dragonundertheworld/module-robot/img/final_robot.jpg

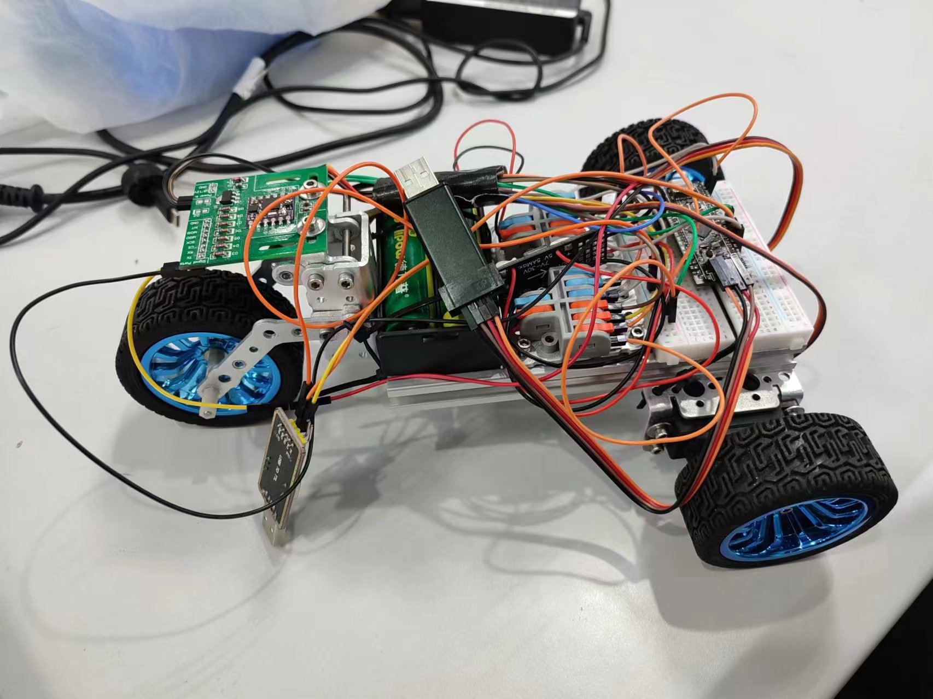
img/final_robot.jpg
