dragonundertheworld/module-robot/img/code_of_yaw_calibration.png

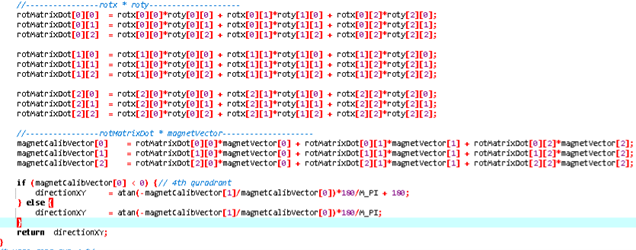
img/code_of_yaw_calibration.png
