dragonundertheworld/module-robot/img/test_and_record.jpg

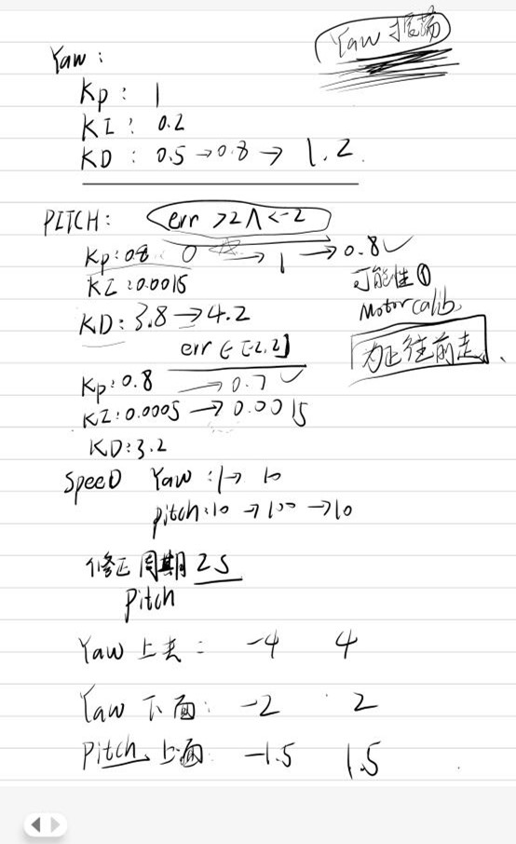
img/test_and_record.jpg
