dragonundertheworld/module-robot/Core/Src/main.c

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
/* Includes ------------------------------------------------------------------*/
#include "main.h"
#include "cmsis_os.h"

/* USER CODE BEGIN Includes */
#include "stdio.h"
#include "stdlib.h"
#include "string.h"
/* USER CODE END Includes */

/* USER CODE BEGIN PTD */
int SPEED;//要达到的速度
float PitchTemp = 0;
float YawTemp = 0;
float YawAngleCalibration = -42;
float PitchAngleCalibration = 3 ;
float PitchAverage = 0;
float YawAverage = 0;
int YawCorrectionSpeed = 0;
float PitchError = 0;
float SUM = 0;
int	flag=0;
typedef union {
    uint16_t   U16Data;
    int16_t    I16Data;
    int16_t    T16Data;
    uint8_t    C8Data[2];
}DataJointUnion;
typedef union {
    int16_t	   P16Data;
    uint8_t    P8Data[2];
}DataPitchUnion;

typedef union {
    int16_t	   Y16Data;
    uint8_t    Y8Data[2];
}DataYawUnion;

/* USER CODE END PTD */

/* USER CODE BEGIN PD */
#define	UART2_RECV_BUFF_LEN			11
#define UART1_RECV_BUFF_LEN         11
#define UART1_TRANS_BUFF_LEN        64
#define UART2_SEND_BUFF_LEN         64
#define	Pitch_Buff_LEN				64
#define	Yaw_Buff_LEN				64

/* USER CODE END PD */

TIM_HandleTypeDef htim2;

UART_HandleTypeDef huart1;
UART_HandleTypeDef huart2;

osThreadId defaultTaskHandle;
osThreadId myTask02Handle;
osThreadId myTask03Handle;
osThreadId myTask04Handle;
osThreadId myTask05Handle;
osThreadId myTask06Handle;
osSemaphoreId myBinarySem_UART1GY953RecvHandle;
osSemaphoreId myBinarySem_UART2SendHandle;
osSemaphoreId myBinarySem_UART1ToUART2TransReadyHandle;
osSemaphoreId myBinarySem_UART2RecvHandle;
osSemaphoreId myBinarySem_MotorSpdChangeHandle;
osSemaphoreId myBinarySem_YawCorrectionHandle;
osSemaphoreId myBinarySem_PitchCorrectionHandle;
osSemaphoreId myBinarySem_YawCorrectHandle;
/* USER CODE BEGIN PV */
uint8_t     UART1RecvBuff[UART1_RECV_BUFF_LEN];
uint8_t     UART1TransToUART2Buff[UART1_TRANS_BUFF_LEN];
int16_t     PitchBuff[Pitch_Buff_LEN];
int16_t     YawBuff[Pitch_Buff_LEN];
uint16_t    UART1TransToUART2Size=0;
uint16_t    PitchSize=0;
uint16_t    YawSize=0;
uint16_t    UART2SendSize=0;
uint8_t     UART2SendBuff[UART2_SEND_BUFF_LEN];
uint8_t 	UART2RecvBuff[UART2_RECV_BUFF_LEN];
/* USER CODE END PV */

void SystemClock_Config(void);
static void MX_GPIO_Init(void);
static void MX_TIM2_Init(void);
static void MX_USART1_UART_Init(void);
static void MX_USART2_UART_Init(void);
void StartDefaultTask(void const * argument);
void StartTaskUART1GY953(void const * argument);
void StartTaskUART2(void const * argument);
void StartTaskMotorCtrl(void const * argument);
void StartTaskPID(void const * argument);
void StartTaskYawCorrect(void const * argument);

/**
  * @brief  The application entry point.
  * @retval int
  */
int main(void)
{
  /* MCU Configuration--------------------------------------------------------*/

  /* Reset of all peripherals, Initializes the Flash interface and the Systick. */
  HAL_Init();

  /* Configure the system clock */
  SystemClock_Config();

  /* Initialize all configured peripherals */
  MX_GPIO_Init();
  MX_TIM2_Init();
  MX_USART1_UART_Init();
  MX_USART2_UART_Init();
  /* Create the semaphores(s) */
  /* definition and creation of myBinarySem_UART1GY953Recv */
  osSemaphoreDef(myBinarySem_UART1GY953Recv);
  myBinarySem_UART1GY953RecvHandle = osSemaphoreCreate(osSemaphore(myBinarySem_UART1GY953Recv), 1);

  /* definition and creation of myBinarySem_UART2Send */
  osSemaphoreDef(myBinarySem_UART2Send);
  myBinarySem_UART2SendHandle = osSemaphoreCreate(osSemaphore(myBinarySem_UART2Send), 1);

  /* definition and creation of myBinarySem_UART1ToUART2TransReady */
  osSemaphoreDef(myBinarySem_UART1ToUART2TransReady);
  myBinarySem_UART1ToUART2TransReadyHandle = osSemaphoreCreate(osSemaphore(myBinarySem_UART1ToUART2TransReady), 1);

  /* definition and creation of myBinarySem_UART2Recv */
  osSemaphoreDef(myBinarySem_UART2Recv);
  myBinarySem_UART2RecvHandle = osSemaphoreCreate(osSemaphore(myBinarySem_UART2Recv), 1);

  /* definition and creation of myBinarySem_MotorSpdChange */
  osSemaphoreDef(myBinarySem_MotorSpdChange);
  myBinarySem_MotorSpdChangeHandle = osSemaphoreCreate(osSemaphore(myBinarySem_MotorSpdChange), 1);

  /* definition and creation of myBinarySem_YawCorrection */
  osSemaphoreDef(myBinarySem_YawCorrection);
  myBinarySem_YawCorrectionHandle = osSemaphoreCreate(osSemaphore(myBinarySem_YawCorrection), 1);

  /* definition and creation of myBinarySem_PitchCorrection */
  osSemaphoreDef(myBinarySem_PitchCorrection);
  myBinarySem_PitchCorrectionHandle = osSemaphoreCreate(osSemaphore(myBinarySem_PitchCorrection), 1);

  /* definition and creation of myBinarySem_YawCorrect */
  osSemaphoreDef(myBinarySem_YawCorrect);
  myBinarySem_YawCorrectHandle = osSemaphoreCreate(osSemaphore(myBinarySem_YawCorrect), 1);

  /* Create the thread(s) */
  /* definition and creation of defaultTask */
  osThreadDef(defaultTask, StartDefaultTask, osPriorityNormal, 0, 128);
  defaultTaskHandle = osThreadCreate(osThread(defaultTask), NULL);

  /* definition and creation of myTask02 */
  osThreadDef(myTask02, StartTaskUART1GY953, osPriorityIdle, 0, 128);
  myTask02Handle = osThreadCreate(osThread(myTask02), NULL);

  /* definition and creation of myTask03 */
  osThreadDef(myTask03, StartTaskUART2, osPriorityIdle, 0, 128);
  myTask03Handle = osThreadCreate(osThread(myTask03), NULL);

  /* definition and creation of myTask04 */
  osThreadDef(myTask04, StartTaskMotorCtrl, osPriorityIdle, 0, 128);
  myTask04Handle = osThreadCreate(osThread(myTask04), NULL);

  /* definition and creation of myTask05 */
  osThreadDef(myTask05, StartTaskPID, osPriorityIdle, 0, 128);
  myTask05Handle = osThreadCreate(osThread(myTask05), NULL);

  /* definition and creation of myTask06 */
  osThreadDef(myTask06, StartTaskYawCorrect, osPriorityIdle, 0, 128);
  myTask06Handle = osThreadCreate(osThread(myTask06), NULL);

  /* Start scheduler */
  osKernelStart();

  /* We should never get here as control is now taken by the scheduler */
  /* Infinite loop */
}

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
/* USER CODE BEGIN 4 */
//下面这两个中断是起始
void HAL_UART_RxCpltCallback(UART_HandleTypeDef *huart)
{
    if(huart == &huart1)
    {
        osSemaphoreRelease(myBinarySem_UART1GY953RecvHandle);
        HAL_UART_Receive_IT(&huart1, UART1RecvBuff, UART1_RECV_BUFF_LEN);//中断接受传感器数据并释放接收信标
    }
}

void HAL_UART_TxCpltCallback(UART_HandleTypeDef *huart)
{
    if(huart == &huart2)
    {
        osSemaphoreRelease(myBinarySem_UART2SendHandle);//释放UART2信标
    }
}

// Motor Control 电机控制函数

void MotorCtrl(uint8_t chn, int16_t spd)
{
	if(spd>200){spd = 200;}

	if(spd<-200){spd = -200;}
	
	switch(chn)
	{
		case 0 :
			spd = spd + 1500;
			__HAL_TIM_SET_COMPARE(&htim2, TIM_CHANNEL_1, spd);	//scope 500~2500
			break;
		case 1 :
			spd = -1 * spd + 1500;
			__HAL_TIM_SET_COMPARE(&htim2, TIM_CHANNEL_2, spd);	// scope 500~2500
			break;
		default:break;
	}
}

// Motor Calibration 电机死区修正函数
void MotorCalib(uint8_t chn, int16_t spd)
{
  int16_t   dead_down_left, dead_down_right,dead_up_left,dead_up_right;
	dead_down_left=-150+3*27;
	dead_up_left=-150+3*62;
	dead_down_right = -150+3*32;
	dead_up_right = -150+3*67;
	switch(chn)
	{
	case 0:
		if(spd < 0)
		{
			spd = spd + dead_down_left;
		}
		else if(spd > 0)
		{
			spd = spd + dead_up_left;
		}
		break;
	case 1:
		if(spd < 0)
		{
			spd = spd + dead_down_right;
		}
		else if (spd > 0)
		{
			spd = spd + dead_up_right;
		}
		break;
	default:
		break;
	}

	MotorCtrl(chn, spd);
}


/* spd > 0  Motor0 Turn Clockwise 电机0 顺时钟转动 小车后退*/
/* spd > 0  Motor1 Turn Clockwise 电机1 逆时钟转动 小车后退*/
// 计算俯仰角与航向角平均值角度
void CalculateAverage(void)//以后需要改进成滤波算法
{
	
	int number = 5;
	float SumOfPitch = 0;
	float SumOfYaw = 0;
	for(int i = 0; i < number; i++)
	{
		SumOfPitch +=  PitchTemp;
		SumOfYaw +=  YawTemp;
		osDelay(20);//这个Delay的作用：50Hz接收频率
	}
	PitchAverage = SumOfPitch / number;  // 全局变量
	YawAverage = SumOfYaw / number;      // 全局变量
}
struct _YawPIDParam
{
	float ActualYaw;        // 定义实际值
	float err;                // 定义偏差值
	float err_last;           // 定义上一个偏差值
	float Kp;                 //定义比例系数
	float Ki;                 //定义积分系数
	float Kd;                 //定义微分系数
	float integral;           //定义积分值
}YawPIDParam;

struct _PitchPIDParam
{
	float ActualPitch;		  // 定义实际值
	float err;                // 定义偏差值
	float err_last;           // 定义上一个偏差值
	float Kp;                 //定义比例系数
	float Ki;                 //定义积分系数
	float Kd;                 //定义微分系数
	float integral;           //定义积分值
}PitchPIDParam;
void YawPIDInit()
{
	YawPIDParam.ActualYaw = 0;
	YawPIDParam.err = 0;
	YawPIDParam.err_last = 0;
	YawPIDParam.Kp = 1;//
	YawPIDParam.Ki = 0.2;
	YawPIDParam.Kd = 1.4;
	YawPIDParam.integral = 0;

}
int YawPIDControl(float YawAverage)
{
	YawPIDInit();
	YawPIDParam.ActualYaw = YawAverage;
	YawPIDParam.err = YawPIDParam.ActualYaw - YawAngleCalibration;
	YawPIDParam.integral += YawPIDParam.err;
	YawPIDParam.ActualYaw = YawPIDParam.Kp* YawPIDParam.err + YawPIDParam.Ki * YawPIDParam.integral + YawPIDParam.Kd * (YawPIDParam.err - YawPIDParam.err_last);
	//UART2SendIntegerVariable(YawPIDParam.Kp);
	YawPIDParam.err_last = YawPIDParam.err;
	YawCorrectionSpeed = (int)(10* YawPIDParam.ActualYaw);//100*PID计算值，得到YawCorrectionSpeed
	//UART2SendIntegerVariable(YawCorrectionSpeed);
	osSemaphoreRelease(myBinarySem_YawCorrectionHandle);//释放Yaw信标
	return YawCorrectionSpeed;
}
int PitchPIDControl(float PitchAverage)
{
		PitchPIDParam.ActualPitch = PitchAverage; // 俯仰角均值传递给实际俯仰角
		PitchPIDParam.err = PitchPIDParam.ActualPitch - PitchAngleCalibration;  // 偏差
		PitchPIDParam.integral += PitchPIDParam.err;
		if (PitchPIDParam.integral > 100 || PitchPIDParam.integral < -100)
		{
			PitchPIDParam.integral = 100;
		}

		if (PitchPIDParam.err >= 2.0 || -2.0 >= PitchPIDParam.err)
		{
			PitchPIDParam.Kp = 1;                                // 定义比例系数
			PitchPIDParam.Ki = 0.0015;                                // 定义积分系数
			PitchPIDParam.Kd = 4.0;
		}
		else if (PitchPIDParam.err < 2.0 && -2.0 < PitchPIDParam.err)
		{
			PitchPIDParam.Kp = 0.8;                                // 定义比例系数
			PitchPIDParam.Ki = 0.0015;                                // 定义积分系数
			PitchPIDParam.Kd = 3.2;
		}
		PitchPIDParam.ActualPitch = PitchPIDParam.Kp * PitchPIDParam.err + PitchPIDParam.Ki * PitchPIDParam.integral + PitchPIDParam.Kd * (PitchPIDParam.err - PitchPIDParam.err_last);
		PitchPIDParam.err_last = PitchPIDParam.err;
		SPEED = (int)(10 * PitchPIDParam.ActualPitch);//更改全局变量speed
		PitchError = PitchPIDParam.err; // 更改全局变量PitchError和SPEED
		
		return SPEED;
}
void update_all_data(void)
{
	CalculateAverage();//更改两个全局变量PitchAverage和YawAverage（平均滤波）
	YawPIDControl(YawAverage);//释放Yaw信标并得到全局变量YawCorrectionSpeed
	PitchPIDControl(PitchAverage);// 更改全局变量PitchError和SPEED
}
void back_to_ground(void)
{
	update_all_data();
	SPEED = 200;
	osSemaphoreRelease(myBinarySem_MotorSpdChangeHandle);
	osDelay(500);//交出电机控制权0.5s,让跷跷板不平衡
	while(PitchError>1.3 || PitchError<-1.3)
	{
			while (YawCorrectionSpeed < -2)//+++++++++++++++++++++++++++++++++++++++++++++++++++++++++++++++++++++++++++++++++++++++++++++++++++++++++++++++++++++++++++++++++++++在【-，-2】，【2，+】这个范围内Yaw调整，还在下方
			{ 	
				YawCorrectionSpeed = -YawCorrectionSpeed;
				osSemaphoreRelease(myBinarySem_MotorSpdChangeHandle);
				osDelay(10);//交出电机控制权
//						MotorCalib(1, -YawCorrectionSpeed);
//						MotorCalib(0, YawCorrectionSpeed);
				if (YawCorrectionSpeed < 5 && YawCorrectionSpeed > -5)//Yaw在这个【-5，5】调整Pitch，不调Yaw，不能动SPEED=0
				{
					osSemaphoreRelease(myBinarySem_MotorSpdChangeHandle);
					osDelay(10);//调用MotorCtrl函数
					break;
				}
				update_all_data();//更新所有的全局变量
			}

		while (YawCorrectionSpeed > 2)//在【-，-2】，【2，+】这个范围内Yaw调整，还在下方
				{ 
					osSemaphoreRelease(myBinarySem_MotorSpdChangeHandle);
					osDelay(10);//调用MotorCtrl函数
	//						MotorCalib(1, -YawCorrectionSpeed);
	//						MotorCalib(0, YawCorrectionSpeed);
					if (YawCorrectionSpeed < 5 && YawCorrectionSpeed > -5)//Yaw在这个【-5，5】调整Pitch，不调Yaw，不能动SPEED=0
					{
						osSemaphoreRelease(myBinarySem_MotorSpdChangeHandle);
						osDelay(10);//调用MotorCtrl函数
						break;
					}
					update_all_data();//更新所有的全局变量
				}
	}
	while(1)
	{
		SPEED = 0;
		osSemaphoreRelease(myBinarySem_MotorSpdChangeHandle);
		osDelay(1);
	}
}
/* USER CODE END 4 */

void StartDefaultTask(void const * argument)
{
  /* USER CODE BEGIN 5 */
	for(;;)
  {
    osDelay(1);
  }
  /* USER CODE END 5 */
}

void StartTaskUART1GY953(void const * argument)
{
  /* USER CODE BEGIN StartTaskUART1GY953 */
	  uint8_t cmd0[]={0xA5,0x15,0xBA};// acceleration data
    uint8_t cmd1[]={0xA5,0x35,0xDA};// magnet data
    uint8_t cmd2[]={0xA5,0x45,0xEA};// Euler data(50Hz)

    DataJointUnion  tempUnion;
    DataPitchUnion	PitchUnion;
    DataYawUnion	YawUnion;
    uint8_t isDirectTransToUART2=0;
    
    //osDelay(1000);//这是干嘛的？
    HAL_UART_Transmit(&huart1, cmd1, sizeof(cmd1), 100);//单片机索要magnet data
    HAL_UART_Transmit(&huart1, cmd2, sizeof(cmd2), 100);//单片机索要Euler data
    
    HAL_UART_Receive_IT(&huart1, UART1RecvBuff, UART1_RECV_BUFF_LEN);//单片机拿到data
  /* Infinite loop */
    for(;;)
	    { 
	        osSemaphoreWait(myBinarySem_UART1GY953RecvHandle, osWaitForever);//一直等从中断来的UART1信标，20ms来一次
	        UART1TransToUART2Size   = 0;
	        PitchSize=0;
	        if(isDirectTransToUART2) {
	            memcpy(UART1TransToUART2Buff, UART1RecvBuff, UART1_RECV_BUFF_LEN);
	            UART1TransToUART2Size   = UART1_RECV_BUFF_LEN;
	        } else {
	            switch(UART1RecvBuff[2]) {
	                case    0x15    :
	                    tempUnion.C8Data[1]     = UART1RecvBuff[4];
	                    tempUnion.C8Data[0]     = UART1RecvBuff[5];
	                    sprintf((UART1TransToUART2Buff + UART1TransToUART2Size), "Ax:%05d ", tempUnion.U16Data);
	                    UART1TransToUART2Size   = UART1TransToUART2Size + 9;
	                    tempUnion.C8Data[1]     = UART1RecvBuff[6];
	                    tempUnion.C8Data[0]     = UART1RecvBuff[7];
	                    sprintf((UART1TransToUART2Buff + UART1TransToUART2Size), "Ay:%05d ", tempUnion.U16Data);
	                    UART1TransToUART2Size   = UART1TransToUART2Size + 9;
	                    tempUnion.C8Data[1]     = UART1RecvBuff[8];
	                    tempUnion.C8Data[0]     = UART1RecvBuff[9];
	                    sprintf((UART1TransToUART2Buff + UART1TransToUART2Size), "Az:%05d \r\n", tempUnion.U16Data);
	                    UART1TransToUART2Size   = UART1TransToUART2Size + 9 + 2;

	                    break;
	                case    0x35    :
	
	                    tempUnion.C8Data[1]     = UART1RecvBuff[4];
	                    tempUnion.C8Data[0]     = UART1RecvBuff[5];
	                    sprintf((UART1TransToUART2Buff + UART1TransToUART2Size), "Mx:%06d ", tempUnion.I16Data);
	                    UART1TransToUART2Size   = UART1TransToUART2Size + 10;
	                    tempUnion.C8Data[1]     = UART1RecvBuff[6];
	                    tempUnion.C8Data[0]     = UART1RecvBuff[7];
	                    sprintf((UART1TransToUART2Buff + UART1TransToUART2Size), "My:%06d ", tempUnion.I16Data);
	                    UART1TransToUART2Size   = UART1TransToUART2Size + 10;
	                    tempUnion.C8Data[1]     = UART1RecvBuff[8];
	                    tempUnion.C8Data[0]     = UART1RecvBuff[9];
	                    sprintf((UART1TransToUART2Buff + UART1TransToUART2Size), "Mz:%06d \r\n", tempUnion.I16Data);
	                    UART1TransToUART2Size   = UART1TransToUART2Size + 10 + 2;
	
	                    break;
	                case    0x45    :
	                    tempUnion.C8Data[1]     = UART1RecvBuff[4];
	                    tempUnion.C8Data[0]     = UART1RecvBuff[5];
	                    tempUnion.T16Data = tempUnion.T16Data/0x64;
	                    sprintf((UART1TransToUART2Buff + UART1TransToUART2Size), "R:%06d ", tempUnion.T16Data);
	                    UART1TransToUART2Size   = UART1TransToUART2Size + 9;
	                    tempUnion.C8Data[1]     = UART1RecvBuff[6];
	                    tempUnion.C8Data[0]     = UART1RecvBuff[7];
	                    tempUnion.T16Data = tempUnion.T16Data/0x64;
	                    sprintf((UART1TransToUART2Buff + UART1TransToUART2Size), "P:%06d ", tempUnion.T16Data);
	
	                    /*俯仰角采集*/
	                    PitchUnion.P8Data[1]     = UART1RecvBuff[6];
	                    PitchUnion.P8Data[0]     = UART1RecvBuff[7];
	                    PitchUnion.P16Data = PitchUnion.P16Data/0x64;
	                    PitchTemp=(float)PitchUnion.P16Data;
	                    //PitchSize  = PitchSize + 9;
	
	                    UART1TransToUART2Size   = UART1TransToUART2Size + 9;
	                    tempUnion.C8Data[1]     = UART1RecvBuff[8];
	                    tempUnion.C8Data[0]     = UART1RecvBuff[9];
	                    tempUnion.T16Data = tempUnion.T16Data/0x64;
	                    sprintf((UART1TransToUART2Buff + UART1TransToUART2Size), "Y:%06d \r\n", tempUnion.T16Data);
	                    UART1TransToUART2Size   = UART1TransToUART2Size + 9 + 2;
	
	                    /*航向角取值*/
	                    YawUnion.Y8Data[1]     = UART1RecvBuff[8];
	                    YawUnion.Y8Data[0]     = UART1RecvBuff[9];
	                    YawUnion.Y16Data = YawUnion.Y16Data/0x64;
	                    YawTemp = (float)YawUnion.Y16Data;//得到一次的值
	                    //YawSize  = YawSize + 9;
	
	                    break;
	            }
	        }
	        osSemaphoreRelease(myBinarySem_UART1ToUART2TransReadyHandle);//释放UART1ToUART2信标
	        osDelay(1);//尽快不断得到新值
	    }
  /* USER CODE END StartTaskUART1GY953 */
}

void StartTaskUART2(void const * argument)
{
  /* USER CODE BEGIN StartTaskUART2 */
	  HAL_UART_Transmit_IT(&huart2, "helloReady!", 11);

  /* Infinite loop */
    for(;;)
    {
        osSemaphoreWait(myBinarySem_UART1ToUART2TransReadyHandle, osWaitForever);//一直等UART1ToUART2信标
        osSemaphoreWait(myBinarySem_UART2SendHandle, osWaitForever);//为什么要等UART2信标100ms？这个信标由中断产生
        memcpy(UART2SendBuff, UART1TransToUART2Buff, UART1TransToUART2Size);
        UART2SendSize   = UART1TransToUART2Size;
        HAL_UART_Transmit_IT(&huart2, UART2SendBuff, UART2SendSize);
        osDelay(1000);//每1000ms往电脑传一次数据，这个速度无所谓，只是看着舒服
    }
  /* USER CODE END StartTaskUART2 */
}

void StartTaskMotorCtrl(void const * argument)
{
  /* USER CODE BEGIN StartTaskMotorCtrl */
	//可以执行
  HAL_TIM_PWM_Start(&htim2, TIM_CHANNEL_1);//打开时钟1
  HAL_TIM_PWM_Start(&htim2, TIM_CHANNEL_2);//打开时钟2
  /* Infinite loop */
	
  for(;;)
  {
//    osSemaphoreWait (myBinarySem_YawCorrectionHandle, osWaitForever);//暂不需要等待信标
		/*------------------------------注释了下面的部分，还换了osdelay的位置---------------------*/
//		while (YawCorrectionSpeed < -3 && YawCorrectionSpeed > 3)
//		{
//			CalculateAverage();
//			YawPIDControl(YawAverage);
			osSemaphoreWait(myBinarySem_MotorSpdChangeHandle,osWaitForever);
			MotorCalib(0, -YawCorrectionSpeed);//SPEED来源于PitchPIDControl，只根据Pitch变
			MotorCalib(1, YawCorrectionSpeed);
			osDelay(1);//不只是不断断循环 = 20ms*5，行进过程中的修正间隔
			MotorCalib(0, SPEED);
			MotorCalib(1, SPEED);
			osDelay(1);
//		}	
		/*------------------------------注释了上面的部分---------------------*/
//		osSemaphoreWait (myBinarySem_PitchCorrectionHandle, osWaitForever); 
  }
  /* USER CODE END StartTaskMotorCtrl */
}

/* USER CODE BEGIN Header_StartTaskPID */
/**
* @brief Function implementing the myTask05 thread.
* @param argument: Not used
* @retval None
*/
/* USER CODE END Header_StartTaskPID */
void StartTaskPID(void const * argument)
{
  /* USER CODE BEGIN StartTaskPID */
  /* Infinite loop */
  for(;;)
  {
    osDelay(1);
  }
  /* USER CODE END StartTaskPID */
}

/* USER CODE BEGIN Header_StartTaskYawCorrect */
/**
* @brief Function implementing the myTask06 thread.
* @param argument: Not used
* @retval None
*/
/* USER CODE END Header_StartTaskYawCorrect */
void StartTaskYawCorrect(void const * argument)
{
  /* USER CODE BEGIN StartTaskYawCorrect */
  /* Infinite loop */
	int err;
  int array=0;
	for(;;)
    {	
		update_all_data();//更新所有的全局变量
		err = YawCorrectionSpeed;
		while (YawCorrectionSpeed < -2)//在【-，-2】，【2，+】这个范围内Yaw调整，还在下方
					{ 	
						YawCorrectionSpeed = -YawCorrectionSpeed;
						osSemaphoreRelease(myBinarySem_MotorSpdChangeHandle);
						osDelay(10);//交出电机控制权
//						MotorCalib(1, -YawCorrectionSpeed);
//						MotorCalib(0, YawCorrectionSpeed);
						if (YawCorrectionSpeed < 5 && YawCorrectionSpeed > -5)//Yaw在这个【-5，5】调整Pitch，不调Yaw，不能动SPEED=0
						{
							osSemaphoreRelease(myBinarySem_MotorSpdChangeHandle);
							osDelay(10);//调用MotorCtrl函数
							break;
						}
						update_all_data();//更新所有的全局变量
					}

		while (YawCorrectionSpeed > 2)//在【-，-2】，【2，+】这个范围内Yaw调整，还在下方
					{ 
						osSemaphoreRelease(myBinarySem_MotorSpdChangeHandle);
						osDelay(10);//调用MotorCtrl函数
//						MotorCalib(1, -YawCorrectionSpeed);
//						MotorCalib(0, YawCorrectionSpeed);
						if (YawCorrectionSpeed < 5 && YawCorrectionSpeed > -5)//Yaw在这个【-5，5】调整Pitch，不调Yaw，不能动SPEED=0
						{
							osSemaphoreRelease(myBinarySem_MotorSpdChangeHandle);
							osDelay(10);//调用MotorCtrl函数
							break;
						}
						update_all_data();//更新所有的全局变量
					}
		while (YawCorrectionSpeed >= -2 && YawCorrectionSpeed <= 2)//Yaw在【-2，2】内往前走
			{
			while(PitchError<=3 && PitchError>=-3 && flag==0)//Pitch在【-，3】内，即在地面上，flag让这一段全局只执行一次
			{
				SPEED = 100;
				osSemaphoreRelease(myBinarySem_MotorSpdChangeHandle);
				osDelay(10);//调用MotorCtrl函数
//				osDelay(8000);//8秒走到顶，距离=8000*100mm
//				HAL_GPIO_TogglePin(GPIOC, GPIO_PIN_13);//闪灯
				update_all_data();//更新所有的全局变量
				
			}
			if(PitchError>3 || PitchError<-3)
			{
				flag=1;
			}
				
			update_all_data();//更新所有的全局变量
			if (YawCorrectionSpeed < 5 && YawCorrectionSpeed > -5)//Yaw在【-5，5】内调整Pitch，不调Yaw
			{
				if(PitchError<=1.5 && PitchError >=-1.5)
				{
					array++;
					SPEED = 0;
					osSemaphoreRelease(myBinarySem_MotorSpdChangeHandle);
					osDelay(10);//调用MotorCtrl函数
					HAL_GPIO_WritePin(GPIOC,GPIO_PIN_13,1);
					if(array>=150)
					{ 
						back_to_ground();
					}
					//UART2SendIntegerVariable(array);
	
				}
				else
				{
					HAL_GPIO_WritePin(GPIOC,GPIO_PIN_13,0);
					MotorCalib(0, SPEED);
					MotorCalib(1, SPEED);
					CalculateAverage();//更改两个全局变量PitchAverage和YawnAverage（平均滤波），并释放MotorSpdChange信标
					break;
				}
			}
		update_all_data();//更新所有的全局变量
  	osDelay(1);
    }

	}
  /* USER CODE END StartTaskYawCorrect */
}

/**
  * @brief  Period elapsed callback in non blocking mode
  * @note   This function is called  when TIM1 interrupt took place, inside
  * HAL_TIM_IRQHandler(). It makes a direct call to HAL_IncTick() to increment
  * a global variable "uwTick" used as application time base.
  * @param  htim : TIM handle
  * @retval None
  */
void HAL_TIM_PeriodElapsedCallback(TIM_HandleTypeDef *htim)
{
  if (htim->Instance == TIM1) {
    HAL_IncTick();
  }
}

/**
  * @brief  This function is executed in case of error occurrence.
  * @retval None
  */
void Error_Handler(void)
{
}

#ifdef  USE_FULL_ASSERT
/**
  * @brief  Reports the name of the source file and the source line number
  *         where the assert_param error has occurred.
  * @param  file: pointer to the source file name
  * @param  line: assert_param error line source number
  * @retval None
  */
void assert_failed(uint8_t *file, uint32_t line)
{
}
#endif /* USE_FULL_ASSERT */
