dragonundertheworld/module-robot/first_try.ioc

Mcu.UserName=STM32F401CCUx
PA1.Signal=S_TIM2_CH2
PA10.Signal=USART1_RX
PA2.Signal=USART2_TX
PA3.Signal=USART2_RX
PA5.Signal=S_TIM2_CH1_ETR
PA9.Signal=USART1_TX
PC13-ANTI_TAMP.Signal=GPIO_Output
