dragonundertheworld/module-robot/(commit log)

2024-07-16 Rename code of yaw calibration.png to code_of_yaw_calibration.png
2024-07-16 Rename circuit design.jpg to circuit_design.jpg
